Dano79sk/Rack_Display/Rack_Display.kicad_pcb

## KiCad design Rack_Display.kicad_pcb (2024-12-16)

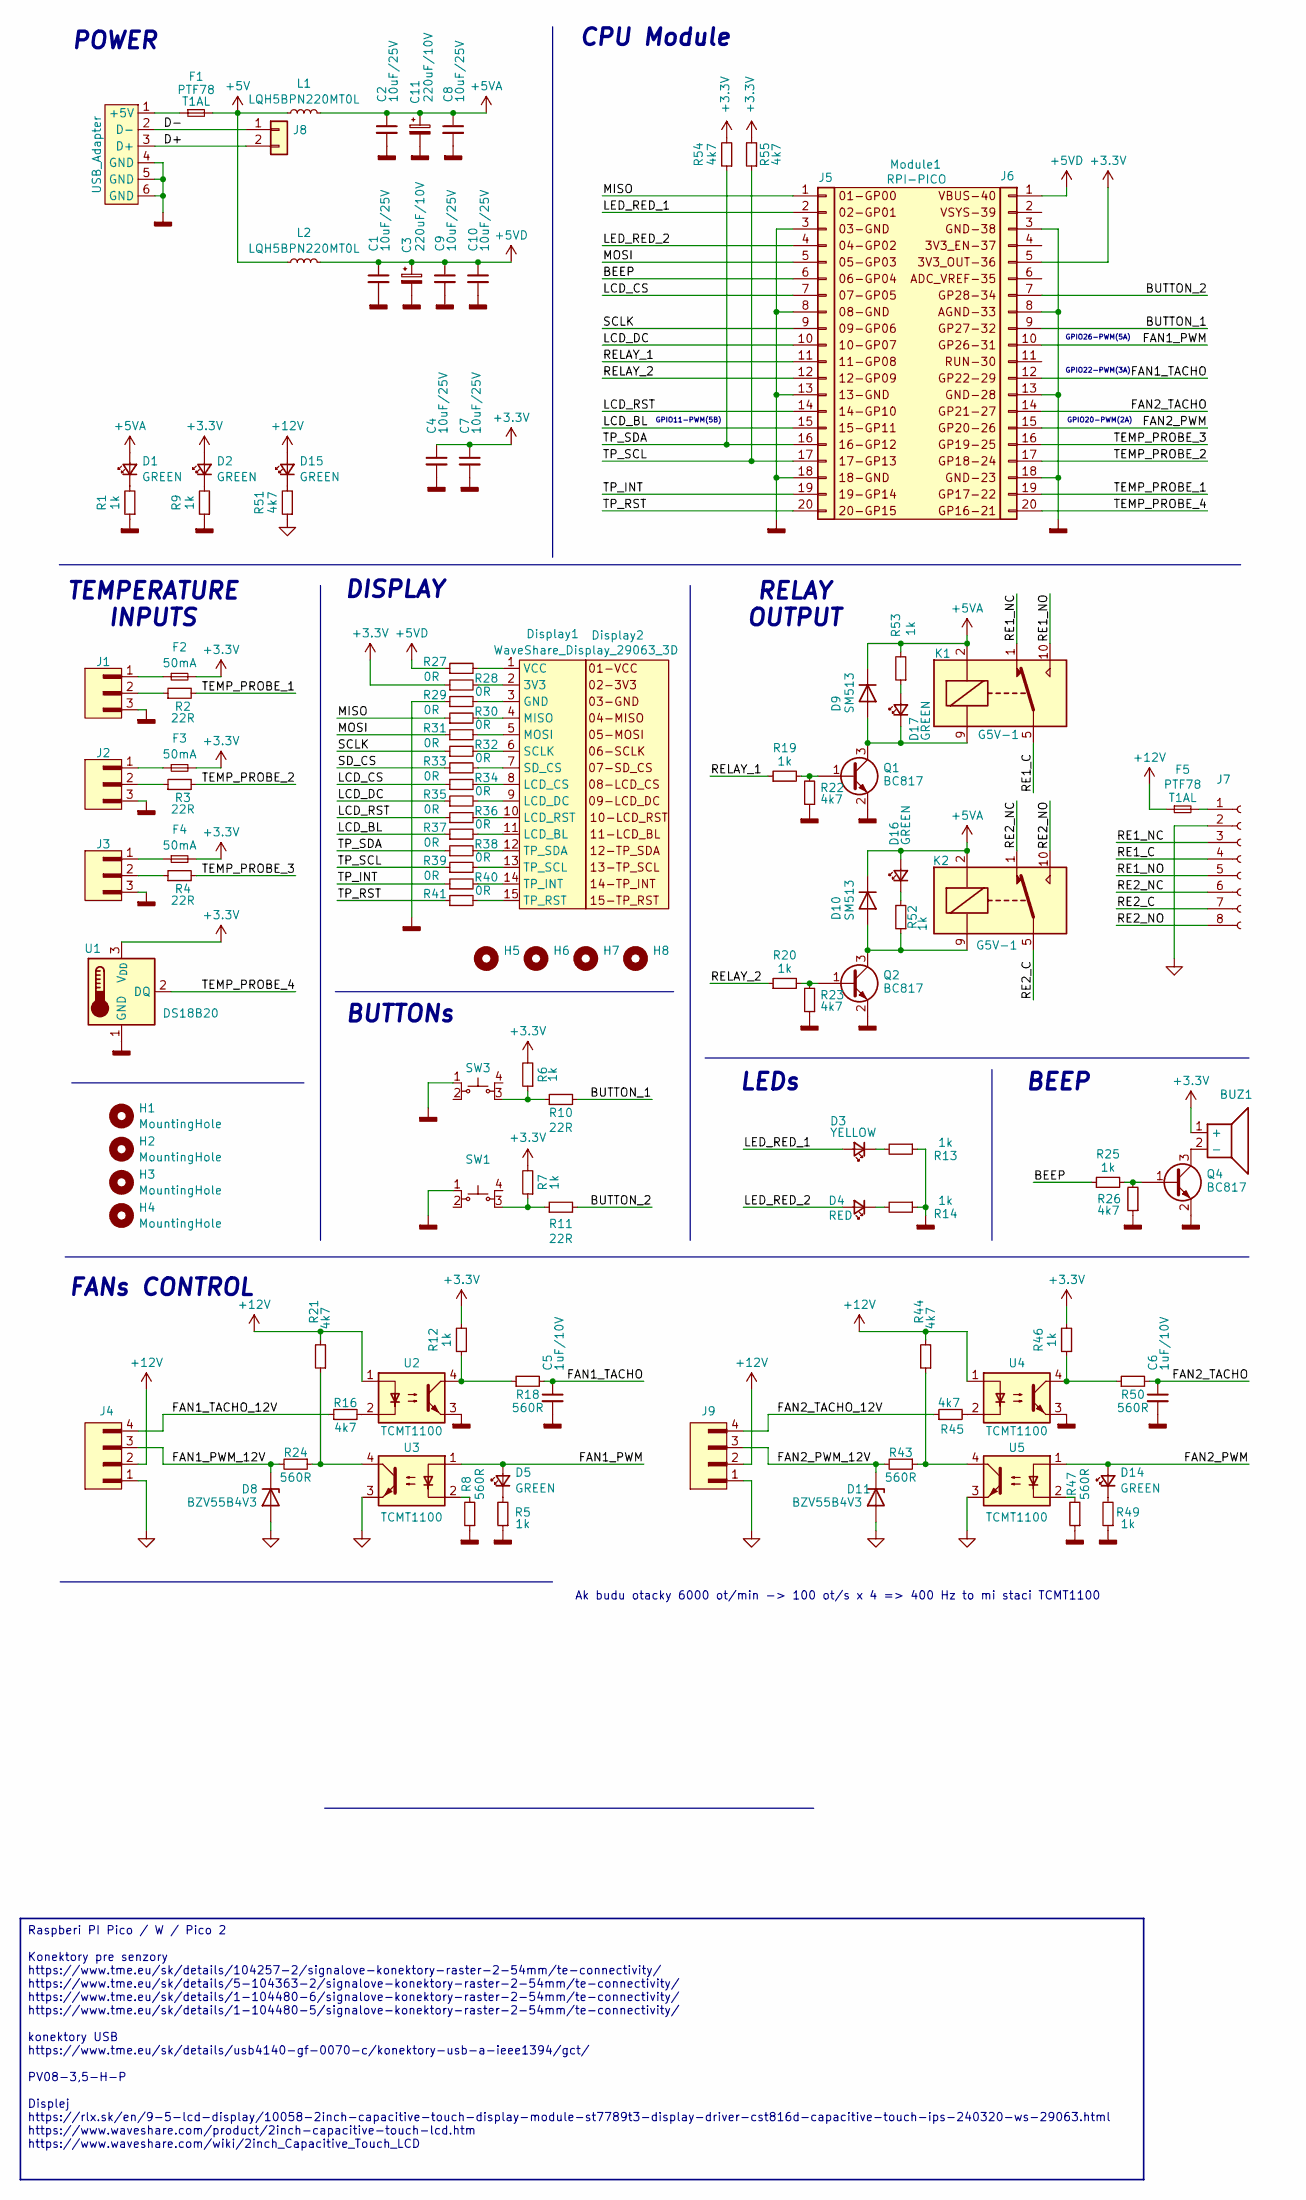
[picture p1: schematic Rack_Display.kicad_sch, Rack Display]

Parts:
BUZ1: LEB9055B-05B-2.7
C1, C4, C7, C9, C10: 10uF/25V; C_1206_3216Metric
C2, C8: 10uF/25V; C_0603_1608Metric
C3, C11: 220uF/10V; CP_Radial_D6.3mm_P2.50mm
C5, C6: 1uF/10V; C_0603_1608Metric
D1, D2, D5, D14, D15: GREEN; LED_0603_1608Metric
D3: YELLOW; LED_D3.0mm_Clear
D4: RED; LED_D3.0mm_Clear
D8, D11: BZV55B4V3; D_MiniMELF
D9, D10: SM513; D_MELF
D16, D17: GREEN; LED_D3.0mm_Clear
Display1: WaveShare_Display_29063; PinHeader_1x15_P2.54mm_Horizontal
Display2: WaveShare_Display_29063_3D; WaveShare_Display_29063
F1, F5: PTF78; Fuseholder_Cylinder-5x20mm_Stelvio-Kontek_PTF78_Horizontal_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
F2, F3, F4: 50mA; Fuse_1206_3216Metric
H1, H2, H3, H4: MountingHole; MountingHole_2.7mm
H5, H6, H7, H8: MountingHole; MountingHole_2.2mm_M2
J1, J2, J3: 5-104363-2
J4, J9: 5-104362-3
J5, J6: Conn_01x20; PinSocket_1x20_P2.54mm_Vertical
J7: Conn_01x08_Socket; PhoenixContact_MC_1,5_8-G-3.5_1x08_P3.50mm_Horizontal
J8: Conn_01x02; Molex_KK-254_AE-6410-02A_1x02_P2.54mm_Vertical
K1, K2: G5V-1; Relay_SPDT_Omron_G5V-1
L1, L2: LQH5BPN220MT0L; L_Taiyo-Yuden_MD-5050
Module1: RPI-PICO; R_Pi_Pico_Module
Module2: USB_Adapter
Q1, Q2, Q4: BC817; SOT-23
R1, R5, R6, R7, R9, R12, R13, R14, R19, R20, R25, R46, R49, R52, R53: 1k; R_0603_1608Metric
R2, R3, R4, R10, R11: 22R; R_0603_1608Metric
R8, R18, R24, R43, R47, R50: 560R; R_0603_1608Metric
R16, R21, R22, R23, R26, R44, R45, R51, R54, R55: 4k7; R_0603_1608Metric
R27, R28, R29, R30, R31, R32, R33, R34, R35, R36, R37, R38, R39, R40, R41: 0R; R_0603_1608Metric
SW1, SW3: 1437565-5
U1: DS18B20; TO-92_Inline
U2, U3, U4, U5: TCMT1100; SOP-4_4.4x2.6mm_P1.27mm

Connections:
+3.3V: BUZ1.1 (+), C4.1, C7.1, D2.2 (A), F2.2, F3.2, F4.2, J6.5, R6.2, R7.2, R12.2, R28.1, R46.2, R54.2, R55.2, U1.3 (V_{DD})
+5V: F1.2, L1.1, L2.1
+5VA: C2.1, C8.1, C11.1, D1.2 (A), D9.1 (K), D10.1 (K), D16.2 (A), K1.2, K2.2, L1.2, R53.2
+5VD: C1.1, C3.1, C9.1, C10.1, J6.1, L2.2, R27.1
+12V: D15.2 (A), F5.1, J4.2, J9.2, R21.2, R44.2, U2.1, U4.1
/BEEP: J5.6, R25.1
/BUTTON_1: J6.9, R10.2
/BUTTON_2: J6.7, R11.2
/D+: J8.2, Module2.3 (D+)
/D-: J8.1, Module2.2 (D-)
/FAN1_PWM: D5.2 (A), J6.10, U3.1
/FAN1_PWM_12V: D8.1 (K), J4.3, R24.2
/FAN1_TACHO: C5.1, J6.12, R18.2
/FAN1_TACHO_12V: J4.4, R16.1
/FAN2_PWM: D14.2 (A), J6.15, U5.1
/FAN2_PWM_12V: D11.1 (K), J9.3, R43.2
/FAN2_TACHO: C6.1, J6.14, R50.2
/FAN2_TACHO_12V: J9.4, R45.1
/LCD_BL: J5.15, R37.1
/LCD_CS: J5.7, R34.1
/LCD_DC: J5.10, R35.1
/LCD_RST: J5.14, R36.1
/LED_RED_1: D3.2 (A), J5.2
/LED_RED_2: D4.2 (A), J5.4
/MISO: J5.1, R30.1
/MOSI: J5.5, R31.1
/RE1_C: J7.4, K1.5, K1.6
/RE1_NC: J7.3, K1.1
/RE1_NO: J7.5, K1.10
/RE2_C: J7.7, K2.5, K2.6
/RE2_NC: J7.6, K2.1
/RE2_NO: J7.8, K2.10
/RELAY_1: J5.11, R19.1
/RELAY_2: J5.12, R20.1
/SCLK: J5.9, R32.1
/SD_CS: R33.1
/TEMP_PROBE_1: J6.19, R2.2
/TEMP_PROBE_2: J6.17, R3.2
/TEMP_PROBE_3: J6.16, R4.2
/TEMP_PROBE_4: J6.20, U1.2 (DQ)
/TP_INT: J5.19, R40.1
/TP_RST: J5.20, R41.1
/TP_SCL: J5.17, R39.1, R55.1
/TP_SDA: J5.16, R38.1, R54.1
GNDD: C1.2, C2.2, C3.2, C4.2, C5.2, C6.2, C7.2, C8.2, C9.2, C10.2, C11.2, J1.3, J2.3, J3.3, J5.3, J5.8, J5.13, J5.18, J6.3, J6.8, J6.13, J6.18, Module2.4 (GND), Module2.5 (GND), Module2.6 (GND), Q1.2 (E), Q2.2 (E), Q4.2 (E), R1.1, R5.1, R8.1, R9.1, R13.1, R14.1, R22.1, R23.1, R26.1, R29.1, R47.1, R49.1, SW1.1, SW3.1, U1.1 (GND), U2.3, U4.3
GNDS: D8.2 (A), D11.2 (A), J4.1, J7.2, J9.1, R51.1, U3.3, U5.3
unnamed: BUZ1.2 (-), Q4.3 (C)
unnamed: D1.1 (K), R1.2
unnamed: D2.1 (K), R9.2
unnamed: D3.1 (K), R13.2
unnamed: D4.1 (K), R14.2
unnamed: D5.1 (K), R5.2
unnamed: D10.2 (A), K2.9, Q2.3 (C), R52.1
unnamed: D14.1 (K), R49.2
unnamed: D15.1 (K), R51.2
unnamed: D16.1 (K), R52.2
unnamed: D17.2 (A), R53.1
unnamed: D9.2 (A), D17.1 (K), K1.9, Q1.3 (C)
unnamed: Display1.2 (3V3), R28.2
unnamed: Display1.3 (GND), R29.2
unnamed: Display1.11 (LCD_BL), R37.2
unnamed: Display1.8 (LCD_CS), R34.2
unnamed: Display1.9 (LCD_DC), R35.2
unnamed: Display1.10 (LCD_RST), R36.2
unnamed: Display1.4 (MISO), R30.2
unnamed: Display1.5 (MOSI), R31.2
unnamed: Display1.6 (SCLK), R32.2
unnamed: Display1.7 (SD_CS), R33.2
unnamed: Display1.14 (TP_INT), R40.2
unnamed: Display1.15 (TP_RST), R41.2
unnamed: Display1.13 (TP_SCL), R39.2
unnamed: Display1.12 (TP_SDA), R38.2
unnamed: Display1.1 (VCC), R27.2
unnamed: F2.1, J1.1
unnamed: F3.1, J2.1
unnamed: F4.1, J3.1
unnamed: J1.2, R2.1
unnamed: J2.2, R3.1
unnamed: J3.2, R4.1
unnamed: F5.2, J7.1
unnamed: F1.1, Module2.1 (+5V)
unnamed: Q1.1 (B), R19.2, R22.2
unnamed: Q2.1 (B), R20.2, R23.2
unnamed: Q4.1 (B), R25.2, R26.2
unnamed: R8.2, U3.2
unnamed: R6.1, R10.1, SW3.3
unnamed: R7.1, R11.1, SW1.3
unnamed: R12.1, R18.1, U2.4
unnamed: R16.2, U2.2
unnamed: R21.1, R24.1, U3.4
unnamed: R43.1, R44.1, U5.4
unnamed: R45.2, U4.2
unnamed: R46.1, R50.1, U4.4
unnamed: R47.2, U5.2

Notes on the sheet:
Raspberi PI Pico / W / Pico 2 Konektory pre senzory https://www.tme.eu/sk/details/104257-2/signalove-konektory-raster-2-54mm/te-connectivity/ https://www.tme.eu/sk/details/5-104363-2/signalove-konektory-raster-2-54mm/te-connectivity/ https://www.tme.eu/sk/details/1-104480-6/signalove-konektory-rast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
FANs CONTROL
CPU Module
BEEP
GPIO22-PWM(3A)
DISPLAY
GPIO26-PWM(5A)
LEDs
GPIO20-PWM(2A)
POWER
Ak budu otacky 6000 ot/min -> 100 ot/s x 4 => 400 Hz to mi staci TCMT1100
TEMPERATURE INPUTS
GPIO11-PWM(5B)
BUTTONs
RELAY OUTPUT

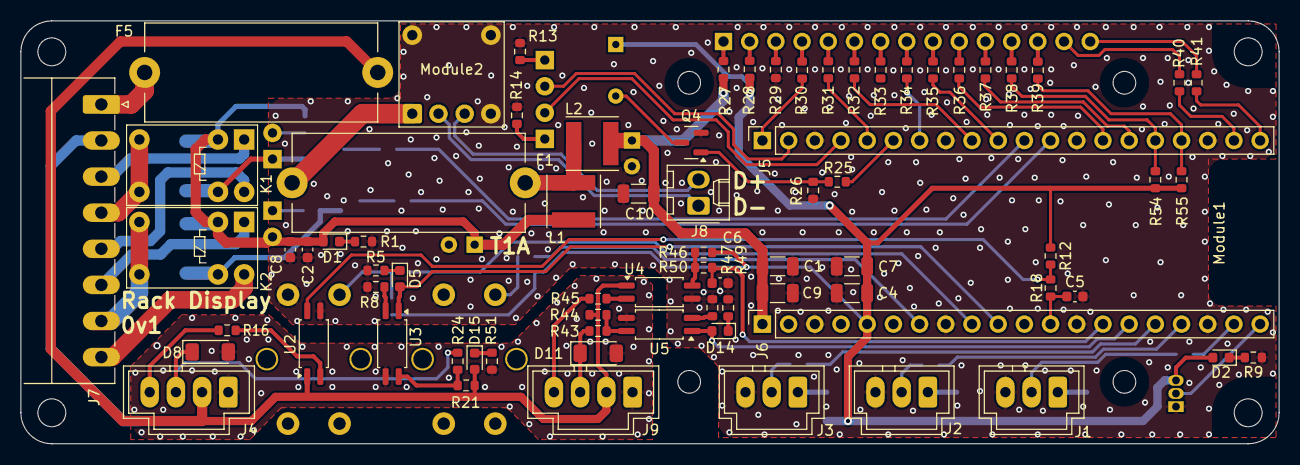
[picture p2: board Rack_Display.kicad_pcb from above]

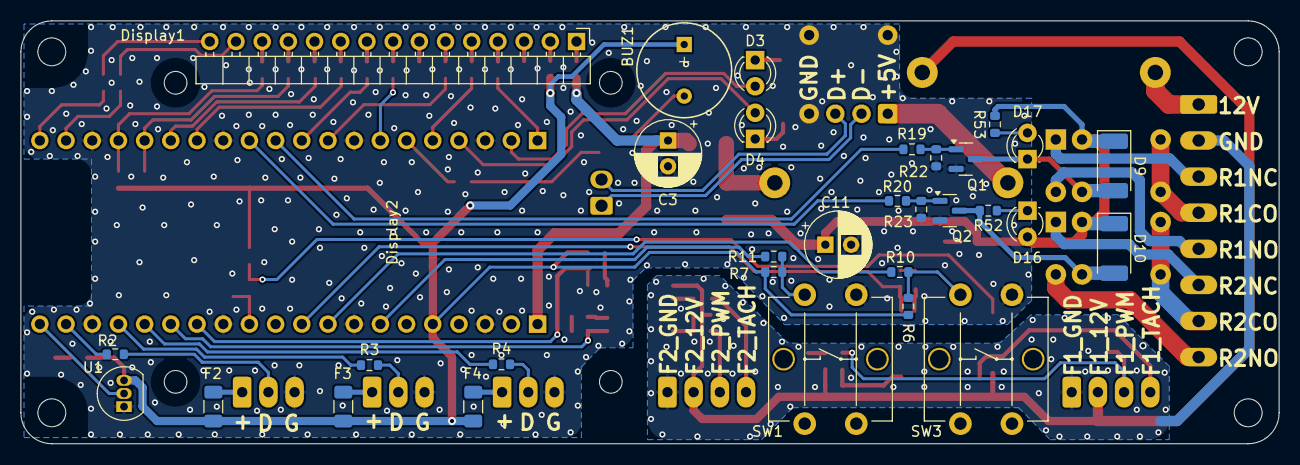
[picture p3: board Rack_Display.kicad_pcb from below]

Board: 2 copper layers, 122.0 x 41.0 mm, 116 parts (32 on the bottom side), 93 nets.
